umrover/mradio/pcb/mradio/mradio.kicad_pcb

## KiCad design pcb/mradio/mradio.kicad_pcb (2026-10-17)

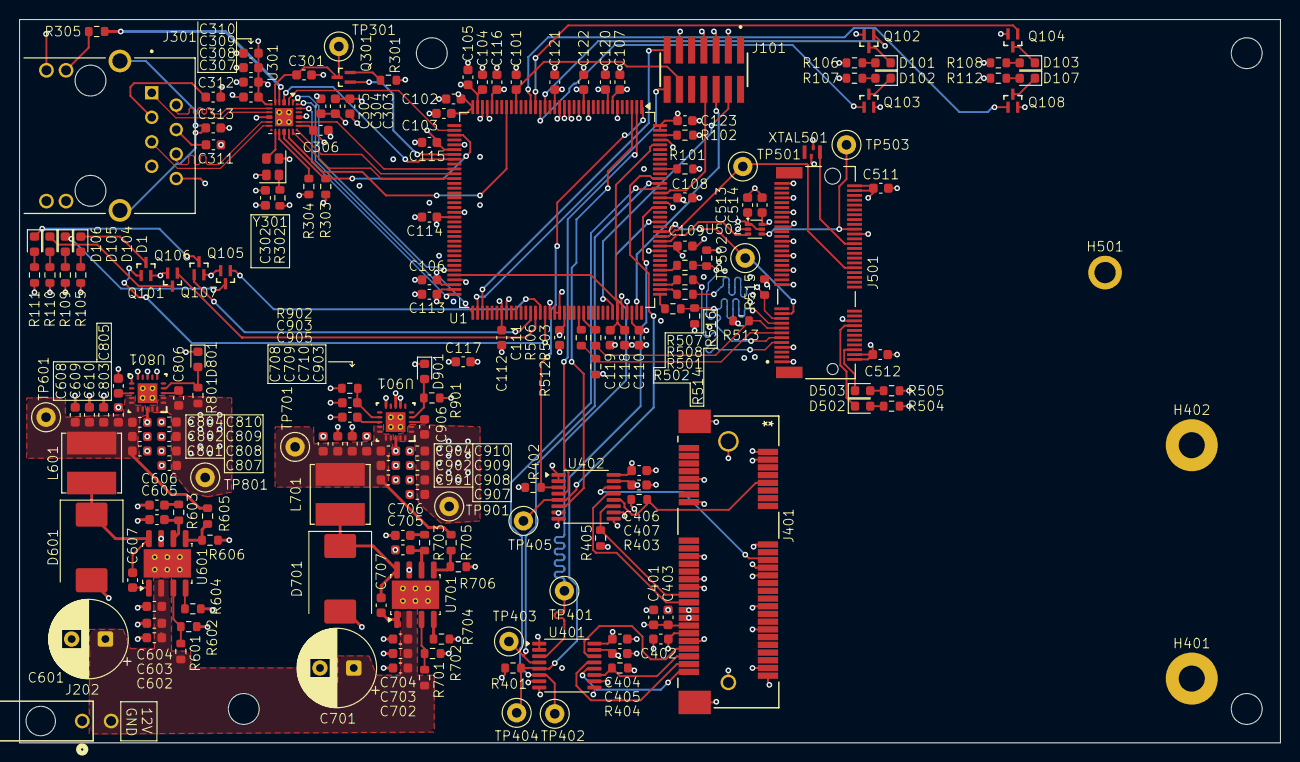
[picture p1: board mradio.kicad_pcb from above]

Board: 6 copper layers, 130.8 x 75.0 mm, 193 parts (0 on the bottom side), 122 nets.

Parts:
C101, C102, C104, C107, C108, C109, C110, C111, C112, C113, C114, C115, C116, C121, C122, C123, C305, C308, C403, C404, C405, C406, C407, C805, C905: 100nF; C_0603_1608Metric
C103, C105, C120, C304, C309, C402: 1uF; C_0603_1608Metric
C106, C117: 4.7uF; C_0603_1608Metric
C118, C119, C602, C603, C604, C702, C703, C704: 2.2uF; C_0603_1608Metric
C301: 0.01uF; C_0603_1608Metric
C302, C311, C312, C513, C514, C607, C707: 0.1uF; C_0603_1608Metric
C303, C310, C511, C512, C802, C803, C804, C808, C809, C810, C902, C903, C903#2, C904, C908, C909, C910: 10uF; C_0603_1608Metric
C306, C307, C806, C906: 10nF; C_0603_1608Metric
C313: 0nF; C_0603_1608Metric
C401, C608, C609, C610, C708, C709, C710, C801, C807, C901, C907: 47uF; C_0603_1608Metric
C601, C701: 100uF; CP_Radial_D8.0mm_P3.50mm
C605: 100pF; C_0603_1608Metric
C606, C706: 29nF; C_0603_1608Metric
C705: 180pF; C_0603_1608Metric
D1, D101, D102, D103, D104, D105, D106, D107, D502, D503, D801, D901: LED; LED_0603_1608Metric
D601, D701: 60V; D_SMC
H401, H402: MountingHole_Pad; MountingHole_2.7mm_M2.5_Pad
H501: MountingHole_Pad; MountingHole_2.2mm_M2_ISO7380_Pad
J101: Conn_02x07_Odd_Even; SAMTEC_FTSH-107-01-X-DV-K
J202: Conn_01x02; CONN_2125280000_02_MOL
J301: 2250065-1; BEL_2250065-1
J401: MM60-52B1-E1-R650; CONN_MM60-52B1-E1-R650_JAE
J501: MDT420E01001; AMPHENOL_MDT420E01001
L601, L701: 10uH; L_Bourns_SRN6045TA
Q101, Q102, Q103, Q104, Q105, Q106, Q107, Q108: Q_NMOS; SSM_TOS_REAL
Q301: SSM3K56FS_LF; SSM_TOS
R101, R102, R401, R402, R403, R404, R405, R512, R513, R514, R515, R516: 10K; R_0603_1608Metric
R105, R106, R107, R108, R109, R110, R111, R112, R504, R505: 1K; R_0603_1608Metric
R301, R501, R502, R503, R506, R507, R508, R902: 0; R_0603_1608Metric
R302: 70k; R_0603_1608Metric
R303: 2.2k; R_0603_1608Metric
R304: 6.49k; R_0603_1608Metric
R305: 250; R_0603_1608Metric
R601, R701: 442k; R_0603_1608Metric
R602, R702: 90.9k; R_0603_1608Metric
R603: 6.34k; R_0603_1608Metric
R604, R704: 193k; R_0603_1608Metric
R605: 37k; R_0603_1608Metric
R606, R706: 10.2k; R_0603_1608Metric
R703: 3.74k; R_0603_1608Metric
R705: 17.4k; R_0603_1608Metric
R801, R901: 1.2k; R_0603_1608Metric
TP301, TP401, TP402, TP403, TP404, TP405, TP501, TP502, TP503: TestPoint; TestPoint_Loop_D1.80mm_Drill1.0mm_Beaded
TP601: 3v7_TP; TestPoint_Loop_D1.80mm_Drill1.0mm_Beaded
TP701: 2v2_TP; TestPoint_Loop_D1.80mm_Drill1.0mm_Beaded
TP801: 3v3_TP; TestPoint_Loop_D1.80mm_Drill1.0mm_Beaded
TP901: 1v8_TP; TestPoint_Loop_D1.80mm_Drill1.0mm_Beaded
U1: STM32H745ZITx; LQFP-144_20x20mm_P0.5mm
U301: DP83825I; Texas_RMQ0024A_WQFN-24-1EP_3x3mm_P0.4mm_EP1.9x1.9mm
U401, U402: 74AVC4T774; TSSOP-16_4.4x5mm_P0.65mm
U502: SN74LVC1T45DRL; SOT-563
U601, U701: TPS54560BDDA; Texas_R-PDSO-G8_EP2.95x4.9mm_Mask2.4x3.1mm_ThermalVias
U801, U901: TPS7A8500ARGRR; TPS7A8500RGRR
XTAL501: SIT1533AI-H4-DCC-32.768E; XTAL4_SiT1533_SIT
Y301: DSC1525JL2A-25M00000T; Oscillator_SMD_SeikoEpson_SG210-4Pin_2.5x2.0mm

Connections:
+1V8: C102.1, C103.1, C104.1, C105.1, C106.2, C107.1, C108.1, C109.1, C110.1, C111.1, C112.1, C113.1, C114.1, C115.1, C116.1, C117.1, C120.1, C121.1, C122.1, C123.1, C302.1, C303.2, C304.2, C305.2, C306.2, C404.1, C406.1, C513.1, C906.1, C907.1, C908.1, C909.1, C910.1, J101.3, R102.2, R302.1, R303.1, R401.1, R402.1, R512.1, R513.1, R514.1, R515.1, R516.1, TP901.1 (1_1), U1.7 (VDD), U1.8 (VBAT), U1.13 (VDD), U1.19 (VDD), U1.32 (VDD), U1.35 (VREF+), U1.36 (VDDA), U1.42 (VDD), U1.56 (VDD), U1.70 (VDDLDO), U1.71 (VDD), U1.79 (VDD), U1.92 (VDD), U1.105 (VDDLDO), U1.106 (VDD), U1.119 (VDD), U1.129 (VDD), U1.143 (VDDLDO), U1.144 (VDD), U301.19 (VDDIO), U401.1 (DIR1), U401.2 (DIR2), U401.7 (DIR3), U401.16 (V_{CCA}), U402.1 (DIR1), U402.2 (DIR2), U402.16 (V_{CCA}), U502.1 (VCCA), U502.5 (DIR), U901.1 (OUT), U901.2 (SNS), U901.19 (OUT), U901.20 (OUT), Y301.4 (Vcc)
+2V2: C708.1, C709.1, C710.1, C901.1, C902.1, C903#2.1, C904.1, L701.2, R705.1, TP701.1 (1_1), U901.14 (EN), U901.15 (IN), U901.16 (IN), U901.17 (IN)
+3V3: C307.2, C308.2, C309.2, C310.2, C401.1, C402.1, C403.1, C405.1, C407.1, C511.1, C512.1, C514.2, C806.1, C807.1, C808.1, C809.1, C810.1, J401.2 (+3V3AUX), J401.24 (+3V3AUX), J401.39 (+3V3AUX), J401.41 (+3V3AUX), J401.52 (+3V3AUX), J501.2, J501.4, J501.72, J501.74, R105.2, R106.2, R107.2, R108.2, R109.2, R110.2, R111.2, R112.2, R403.1, R404.1, R504.1, R505.1, R801.2, R901.2, R902.1, TP801.1 (1_1), U1.90 (VDD50_USB), U1.91 (VDD33_USB), U301.6 (VDDA3V3), U401.15 (V_{CCB}), U402.15 (V_{CCB}), U502.6 (VCCB), U801.1 (OUT), U801.2 (SNS), U801.19 (OUT), U801.20 (OUT), XTAL501.4 (Vdd)
+3V7: C608.1, C609.1, C610.1, C801.1, C802.1, C803.1, C804.1, L601.2, R605.1, TP601.1 (1_1), U801.14 (EN), U801.15 (IN), U801.16 (IN), U801.17 (IN)
+12V: C601.1, C602.1, C603.1, C604.1, C701.1, C702.1, C703.1, C704.1, J202.2, R601.1, R701.1, U601.2 (VIN), U701.2 (VIN)
/2.4-5 Ghz/M2_WL_REG_ON: J501.56, TP503.1 (1_1), U502.4 (B)
/2.4-5 Ghz/SDIO_CK: J501.9, R508.1
/2.4-5 Ghz/SDIO_CMD: J501.11, R507.1, R516.2
/2.4-5 Ghz/SDIO_D0: J501.13, R506.1, R512.2
/2.4-5 Ghz/SDIO_D1: J501.15, R503.1, R513.2
/2.4-5 Ghz/SDIO_D2: J501.17, R502.1, R514.2
/2.4-5 Ghz/SDIO_D3: J501.19, R501.1, R515.2
/900 Mhz/SPI1_CS_3V3: J401.51 (Reserved), U401.12 (B3)
/900 Mhz/SPI1_MISO_3V3: J401.47 (Reserved), R404.2, U401.11 (B4)
/900 Mhz/SPI1_MOSI_3V3: J401.49 (Reserved), U401.13 (B2)
/900 Mhz/SPI1_SCK_3V3: J401.45 (Reserved), U401.14 (B1)
/900 Mhz/SPI_INT_3V3: J401.10 (UIM_DATA), R403.2, U402.12 (B3)
/900 Mhz/WM_BUSY_3V3: J401.31 (PETn0), R405.2, U402.11 (B4)
/900 Mhz/WM_RESET_3V3: J401.22 (~PERST), U402.14 (B1)
/900 Mhz/WM_WAKE_3V3: J401.33 (PETp0), U402.13 (B2)
/Ethernet/ETH_LINK: R305.2, U301.4 (LED0/S(ANEG_Dis))
/Ethernet/ETH_RD+: J301.1 (RDP), U301.8 (RD+)
/Ethernet/ETH_RD-: J301.2 (RDN), U301.7 (RD-)
/Ethernet/ETH_TD+: J301.5 (TDP), U301.11 (TD+)
/Ethernet/ETH_TD-: J301.6 (TDN), U301.10 (TD-)
/MCU/BOOT0: R101.1, U1.135 (BOOT0)
/MCU/M4_DBG1: Q102.G, U1.21 (PF7)
/MCU/M4_DBG2: Q103.G, U1.22 (PF8)
/MCU/M7_DBG1: Q104.G, U1.23 (PF9)
/MCU/M7_DBG2: Q108.G, U1.24 (PF10)
/MCU/NRST: C101.1, J101.12, U1.27 (NRST)
/MCU/STLINK_RX: J101.13, U1.75 (PB15)
/MCU/STLINK_TX: J101.14, U1.74 (PB14)
/MCU/SWCLK: J101.6, U1.107 (PA14)
/MCU/SWDIO: J101.4, U1.102 (PA13)
/MCU/SWO: J101.8, U1.130 (PB3)
/MCU/SoS_LED1: Q107.G, U1.85 (PD15)
/MCU/SoS_LED2: Q106.G, U1.86 (PG6)
/MCU/SoS_LED3: Q105.G, U1.87 (PG7)
/MCU/SoS_LED4: Q101.G, U1.88 (PG8)
/MCU/VCAP: C118.1, C119.1, U1.68 (VCAP), U1.103 (VCAP), U1.140 (VCAP)
/Power Distribution/2v2_Buck/FB: R705.2, R706.1, U701.5 (FB)
/Power Distribution/3v7_Buck/FB: R605.2, R606.1, U601.5 (FB)
ETH_CRS_DV: U1.46 (PA7), U301.20 (CRS_DV/S(PhyAdd[1]))
ETH_INT: U1.44 (PA5), U301.3 (INTR/~PWRDN)
ETH_MDC: U1.29 (PC1), U301.16 (MDC)
ETH_MDIO: R303.2, U1.39 (PA2), U301.15 (MDIO)
ETH_REF_CLK: U1.38 (PA1), U301.2 (50MHzOut/LED2/S(RX_DV_EN))
ETH_RESET: Q301.1 (G), U1.43 (PA4)
ETH_RXD0: U1.47 (PC4), U301.18 (RX_D0/S(PhyAdd[0]))
ETH_RXD1: U1.48 (PC5), U301.17 (RX_D1/S(Master/Slave))
ETH_TXD0: U1.72 (PB12), U301.23 (TX_D0)
ETH_TXD1: U1.73 (PB13), U301.24 (TX_D1)
ETH_TX_EN: U1.67 (PB11), U301.1 (TX_EN)
GND: C101.2, C102.2, C103.2, C104.2, C105.2, C106.1, C107.2, C108.2, C109.2, C110.2, C111.2, C112.2, C113.2, C114.2, C115.2, C116.2, C117.2, C118.2, C119.2, C120.2, C121.2, C122.2, C123.2, C301.2, C302.2, C303.1, C304.1, C305.1, C306.1, C307.1, C308.1, C309.1, C310.1, C311.1, C312.1, C313.2, C401.2, C402.2, C403.2, C404.2, C405.2, C406.2, C407.2, C511.2, C512.2, C513.2, C514.1, C601.2, C602.2, C603.2, C604.2, C605.2, C606.2, C608.2, C609.2, C610.2, C701.2, C702.2, C703.2, C704.2, C705.2, C706.2, C708.2, C709.2, C710.2, C801.2, C802.2, C803.2, C804.2, C805.2, C807.2, C808.2, C809.2, C810.2, C901.2, C902.2, C903.2, C903#2.2, C904.2, C905.2, C907.2, C908.2, C909.2, C910.2, D601.2 (A), D701.2 (A), D801.1 (K), D901.1 (K), H401.1 (1_1), H402.1 (1_1), H501.1 (1_1), J101.5, J101.7, J101.11, J202.1, J301.8 (GND), J301.10, J401.4 (GND), J401.9 (GND), J401.15 (GND), J401.18 (GND), J401.21 (GND), J401.26 (GND), J401.27 (GND), J401.29 (GND), J401.34 (GND), J401.35 (GND), J401.37 (GND), J401.40 (GND), J401.43 (GND), J401.50 (GND), J401.MP, J501.1, J501.7, J501.18, J501.33, J501.39, J501.45, J501.51, J501.54, J501.57, J501.63, J501.69, J501.75, Q101.S, Q102.S, Q103.S, Q104.S, Q105.S, Q106.S, Q107.S, Q108.S, R101.2, R301.2, R304.2, R405.1, R602.2, R604.2, R606.2, R702.2, R704.2, R706.2, U1.6 (VSS), U1.12 (VSS), U1.14 (VSSSMPS), U1.16 (VDDSMPS), U1.17 (VFBSMPS), U1.18 (VSS), U1.33 (VSS), U1.34 (VSSA), U1.41 (VSS), U1.55 (VSS), U1.69 (VSS), U1.80 (VSS), U1.89 (VSS), U1.104 (VSS), U1.118 (VSS), U1.128 (VSS), U1.141 (VSS), U301.9 (GND), U301.21 (GND), U301.25 (GND), U401.8 (DIR4), U401.9 (~OE), U401.10 (GND), U402.7 (DIR3), U402.8 (DIR4), U402.9 (~OE), U402.10 (GND), U502.2 (GND), U601.7 (GND), U601.9 (GND), U701.7 (GND), U701.9 (GND), U801.6 (100_mV), U801.8 (GND), U801.10 (800_mV), U801.11 (1.6_V), U801.18 (GND), U801.21 (PAD), U901.7 (200_mV), U901.8 (GND), U901.10 (800_mV), U901.18 (GND), U901.21 (PAD), XTAL501.2 (GND), Y301.2 (GND)
unnamed: C606.1, R603.1
unnamed: C706.1, R703.1
unnamed: D1.2 (A), R105.1
unnamed: D1.1 (K), Q101.D
unnamed: D101.2 (A), R106.1
unnamed: D101.1 (K), Q102.D
unnamed: D102.2 (A), R107.1
unnamed: D102.1 (K), Q103.D
unnamed: D103.2 (A), R108.1
unnamed: D103.1 (K), Q104.D
unnamed: D104.2 (A), R109.1
unnamed: D104.1 (K), Q105.D
unnamed: D105.2 (A), R110.1
unnamed: D105.1 (K), Q106.D
unnamed: D106.2 (A), R111.1
unnamed: D106.1 (K), Q107.D
unnamed: D107.2 (A), R112.1
unnamed: D107.1 (K), Q108.D
unnamed: D502.2 (A), R504.2
unnamed: D502.1 (K), J501.16
unnamed: D503.2 (A), R505.2
unnamed: D503.1 (K), J501.6
unnamed: C607.2, D601.1 (K), L601.1, U601.8 (SW)
unnamed: C707.2, D701.1 (K), L701.1, U701.8 (SW)
unnamed: D801.2 (A), R801.1, U801.4 (PG)
unnamed: D901.2 (A), R901.1, U901.4 (PG)
unnamed: J301.9, R305.1
unnamed: C312.2, J301.3 (RCT)
unnamed: C313.1, J301.SH1 (SHIELD), J301.SH2 (SHIELD__1)
unnamed: C311.2, J301.4 (TCT)
unnamed: C301.1, Q301.3 (D), TP301.1 (1_1), U301.5 (~RST)
unnamed: Q301.2 (S), R301.1
unnamed: R102.1, U1.142 (PDR_ON)
unnamed: R304.1, U301.14 (RBIAS)
unnamed: U301.13 (XI/50MHzIn), Y301.3 (OUT)
unnamed: C607.1, U601.1 (BOOT)
unnamed: C605.1, R603.2, U601.6 (COMP)
unnamed: R601.2, R602.1, U601.3 (EN)
unnamed: R604.1, U601.4 (RT/CLK)
unnamed: C707.1, U701.1 (BOOT)
unnamed: C705.1, R703.2, U701.6 (COMP)
unnamed: R701.2, R702.1, U701.3 (EN)
unnamed: R704.1, U701.4 (RT/CLK)
unnamed: C806.2, U801.3 (FB)
unnamed: C805.1, U801.13 (NR_SS)
unnamed: C903.1, R902.2, U901.12 (BIAS)
unnamed: C906.2, U901.3 (FB)
unnamed: C905.1, U901.13 (NR_SS)
unnamed: J501.50, XTAL501.3 (CLK_Out)
unnamed: R302.2, Y301.1 (OE)
SDMMC1_CK: R508.2, U1.111 (PC12)
SDMMC1_CMD: R507.2, U1.114 (PD2)
SDMMC1_D0: R506.2, U1.95 (PC8)
SDMMC1_D1: R503.2, U1.96 (PC9)
SDMMC1_D2: R502.2, U1.109 (PC10)
SDMMC1_D3: R501.2, U1.110 (PC11)
SPI1_CS: R401.2, TP404.1 (1_1), U1.127 (PG14), U401.5 (A3)
SPI1_MISO: TP402.1 (1_1), U1.131 (PB4), U401.6 (A4)
SPI1_MOSI: TP403.1 (1_1), U1.132 (PB5), U401.4 (A2)
SPI1_SCK: TP401.1 (1_1), U1.124 (PG11), U401.3 (A1)
SPI_INT: TP405.1 (1_1), U1.133 (PB6), U402.5 (A3)
WL_DEV_WAKE: J501.40, TP501.1 (1_1), U1.121 (PD7)
WL_HOST_WAKE: J501.21, TP502.1 (1_1), U1.122 (PG9)
WL_REG_ON: U1.120 (PD6), U502.3 (A)
WM_BUSY: U1.3 (PE4), U402.6 (A4)
WM_RESET: R402.2, U1.1 (PE2), U402.3 (A1)
WM_WAKE: U1.2 (PE3), U402.4 (A2)
