umrover/mradio/fw/mradio/mradio.ioc

Mcu.UserName=STM32H745ZITx
PA1.Signal=ETH_REF_CLK
PA2.Signal=ETH_MDIO
PA4.GPIO_Label=ETH_RESET
PA4.Signal=GPIO_Output
PA5.GPIO_Label=ETH_INT
PA5.Signal=GPXTI5
PA7.Signal=ETH_CRS_DV
PB11.Signal=ETH_TX_EN
PB12.Signal=ETH_TXD0
PB13.Signal=ETH_TXD1
PB14.GPIO_Label=STLINK_TX
PB14.Signal=USART1_TX
PB15.GPIO_Label=STLINK_RX
PB15.Signal=USART1_RX
PB5.Signal=SPI1_MOSI
PB6.GPIO_Label=SPI_INT
PB6.Signal=GPXTI6
PC1.Signal=ETH_MDC
PC10.Signal=SDMMC1_D2
PC11.Signal=SDMMC1_D3
PC12.Signal=SDMMC1_CK
PC4.Signal=ETH_RXD0
PC5.Signal=ETH_RXD1
PC8.Signal=SDMMC1_D0
PC9.Signal=SDMMC1_D1
PD15.GPIO_Label=SoS_LED1
PD15.Signal=GPIO_Output
PD2.Signal=SDMMC1_CMD
PD6.GPIO_Label=WL_REG_ON
PD6.Signal=GPIO_Output
PD7.GPIO_Label=WL_DEV_WAKE
PD7.Signal=GPIO_Output
PE2.GPIO_Label=WM_RESET
PE2.Signal=GPIO_Output
PE3.GPIO_Label=WM_WAKE
PE3.Signal=GPIO_Output
PE4.GPIO_Label=WM_BUSY
PE4.Signal=GPXTI4
PF10.GPIO_Label=M7_DBG2
PF10.Signal=GPIO_Output
PF7.GPIO_Label=M4_DBG1
PF7.Signal=GPIO_Output
PF8.GPIO_Label=M4_DBG2
PF8.Signal=GPIO_Output
PF9.GPIO_Label=M7_DBG1
PF9.Signal=GPIO_Output
PG11.Signal=SPI1_SCK
PG14.GPIO_Label=SPI1_CS
PG14.Signal=GPIO_Output
PG6.GPIO_Label=SoS_LED2
PG6.Signal=GPIO_Output
PG7.GPIO_Label=SoS_LED3
PG7.Signal=GPIO_Output
PG8.GPIO_Label=SoS_LED4
PG8.Signal=GPIO_Output
PG9.GPIO_Label=WL_HOST_WAKE
PG9.Signal=GPXTI9
