umrover/mradio/(commit log)

2026-09-29 matlab script to calc and size buck components
2026-10-02 Add kicad gitignore
2026-10-02 Add initial project skeleton
    [2.4-5_ghz.kicad_sch, 900_mhz.kicad_sch, ethernet.kicad_sch, mradio.kicad_pcb, mradio.kicad_sch, power_distribution.kicad_sch]
2026-10-02 Add ground to power schematic
    [power_distribution.kicad_sch]
2026-10-02 Add ground to ethernet PHY
    [ethernet.kicad_sch]
2026-10-02 Add RJ45 Connector
    [ethernet.kicad_sch]
2026-10-03 Selected catch diode, need ESR for output caps, then input caps
2026-10-03 Add symbols and footprints for m.2 connector
2026-10-04 2.4/5 GHz schematic
    [2.4-5_ghz.kicad_sch]
2026-10-04 PHY schematic started
    [ethernet.kicad_sch]
2026-10-05 Input caps
    [power_distribution.kicad_sch]
2026-10-05 Finished buck
    [power_distribution.kicad_sch]
2026-10-05 Add level shifters to 2.4/5 GHz
    [2.4-5_ghz.kicad_sch]
2026-10-05 Add some capacitor jits
    [2.4-5_ghz.kicad_sch]
2026-10-05 Add pull ups to WiFi, change annotation method
    [2.4-5_ghz.kicad_sch]
2026-10-06 Add footprints
    [2.4-5_ghz.kicad_sch]
2026-10-06 Fix pull up voltage
    [2.4-5_ghz.kicad_sch]
2026-10-07 updated ioc and began mcu schematic
    [ethernet.kicad_sch, mradio.kicad_sch, power_distribution.kicad_sch]
2026-10-07 ethernet updated to 1v8
    [ethernet.kicad_sch]
2026-10-07 reverted ethernet
    [ethernet.kicad_sch]
2026-10-07 Added 5.3V Buck
    [power_distribution.kicad_sch]
2026-10-07 buck/ldo symbol and matlab script updates
2026-10-07 oscillator and magjack
    [ethernet.kicad_sch]
2026-10-08 ethernet done
    [ethernet.kicad_sch]
2026-10-08 eth optional resistor
    [ethernet.kicad_sch]
2026-10-08 Separated converters, 5V and 3v3 lines done
    [3v3_LDO.kicad_sch, 3v7_Buck.kicad_sch, 5V_LDO.kicad_sch, 5v5_Buck.kicad_sch, power_distribution.kicad_sch]
2026-10-08 Fixed passives
    [3v3_LDO.kicad_sch, 3v7_Buck.kicad_sch, 5V_LDO.kicad_sch, 5v5_Buck.kicad_sch]
2026-10-08 mcu schematic mostly done, need to get stlinkv3 header
    [3v3_LDO.kicad_sch, 3v7_Buck.kicad_sch, 5V_LDO.kicad_sch, 5v5_Buck.kicad_sch, ethernet.kicad_sch, mradio.kicad_sch, power_distribution.kicad_sch]
2026-10-08 eth updates
    [ethernet.kicad_sch]
2026-10-08 finalized mcu schematic for review, using LDO-only mode and assuming 3.3V MCU input
    [mradio.kicad_sch]
2026-10-09 label cleanup
    [900_mhz.kicad_sch, ethernet.kicad_sch]
2026-10-10 ethernet edits
    [ethernet.kicad_sch]
2026-10-10 some fixes, missing level shifter
    [900_mhz.kicad_sch, ethernet.kicad_sch]
2026-10-10 Voltage conversion
    [1v8_LDO.kicad_sch, 3v3_LDO.kicad_sch, 3v7_Buck.kicad_sch, 5v5_Buck.kicad_sch, power_distribution.kicad_sch]
2026-10-10 Fixed passive numbers
    [1v8_LDO.kicad_sch, 2.4-5_ghz.kicad_sch]
2026-10-10 changed eth oscillator
    [ethernet.kicad_sch]
2026-10-10 ethernet oscillator
    [ethernet.kicad_sch]
2026-10-10 level shifters and necessary pull up/downs for 900mhz, kicad autofixes
    [3v3_LDO.kicad_sch, 3v7_Buck.kicad_sch, 5V_LDO.kicad_sch, 5v5_Buck.kicad_sch, 900_mhz.kicad_sch, power_distribution.kicad_sch]
2026-10-12 Schematic review updates
2026-10-12 Add footprints, test points, unify 3v3
2026-10-12 LDO footprint updates
2026-10-12 Buck footprint updates
2026-10-12 changed eth mosfet
2026-10-12 Input connector
2026-10-12 remove power flag for ERC
2026-10-12 Update some footprints
2026-10-12 Input connector footprint
2026-10-12 Add mounting holes
2026-10-13 Added first buck to layout
2026-10-13 Finished 12->3v3 circuit and 2v2 buck
2026-10-13 updated mcu schematic to support 1.8V
2026-10-13 power conversion
2026-10-13 Add footprint lib for flashing header
2026-10-13 fix fet footprints
2026-10-13 Fix footprints
2026-10-14 added stm32h7 toolchain
2026-10-14 gnd + power planes
2026-10-14 add some more 900 MHz traces
2026-10-15 12v to 3v3 circuit
2026-10-15 all traces routed
2026-10-15 update mounting holes
2026-10-15 switch to polygon for 12V
2026-10-16 Silkscreens and dfm fixes
2026-10-17 bring back mounting holes
2026-10-17 PHY stitching vias and LDO bias pin
